delan/usb3sun/hardware/pcb/playgrounds/led/led.kicad_pcb

## KiCad design hardware/pcb/playgrounds/led/led.kicad_pcb (2023-09-26)

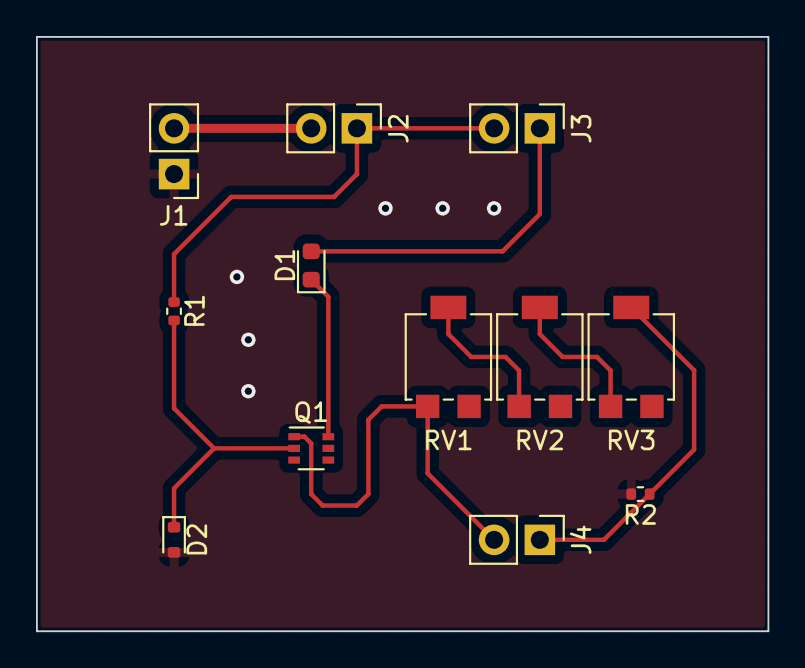
[picture p4: board led.kicad_pcb from above]

Board: 2 copper layers, 40.6 x 33.0 mm, 12 parts (0 on the bottom side), 10 nets.

Parts:
D1: 19-213/Y2C-CQ2R2L/3T(CY); LED_0603_1608Metric
D2: CMOZ1L8; D_SOD-523
J1, J2, J3, J4: PinHeader_1x02_P2.54mm_Vertical
Q1: MMDT2222A; SOT-363_SC-70-6
R1: 1K; R_0402_1005Metric
R2: 100R; R_0402_1005Metric
RV1: 20K; Potentiometer_Bourns_3314G_Vertical
RV2: 2K; Potentiometer_Bourns_3314G_Vertical
RV3: 200R; Potentiometer_Bourns_3314G_Vertical

Connections:
GND: D2.2 (A), J1.1, R2.2
unnamed: D1.2 (A), J3.1
unnamed: D1.1 (K), Q1.6 (C1)
unnamed: D2.1 (K), Q1.2 (B1), R1.2
unnamed: J2.1, J3.2, R1.1
unnamed: J4.1, R2.1, RV3.2
unnamed: J4.2, Q1.1 (E1), RV1.1
unnamed: RV1.2, RV2.1
unnamed: RV2.2, RV3.1
VBUS: J1.2, J2.2
